KSeechan/Autonomous-Rover/Rover Pictures/1.jpg

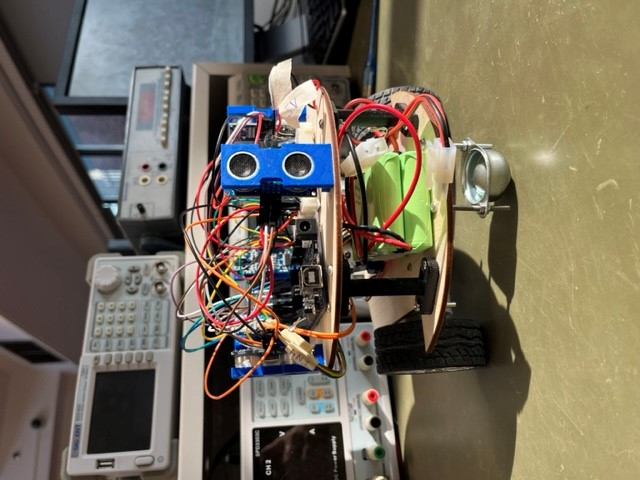
Rover Pictures/1.jpg
