KSeechan/Autonomous-Rover/Rover Pictures/8.jpg

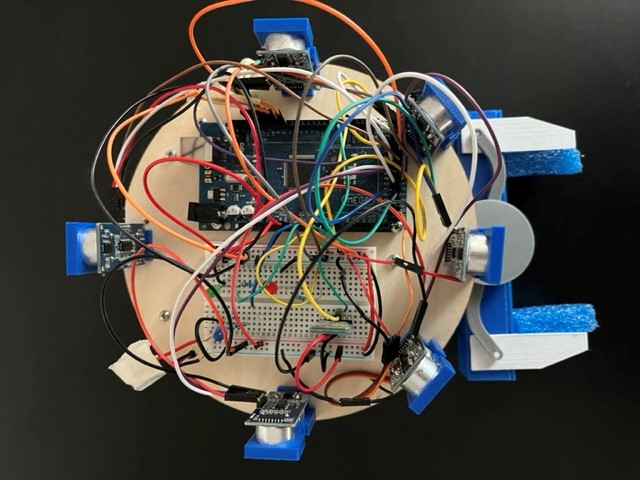
Rover Pictures/8.jpg
