KSeechan/Autonomous-Rover/README.md

# Autonomous-Rover
Arduino powered obstacle avoidance robot
