KSeechan/Autonomous-Rover/Rover Pictures/3.jpg

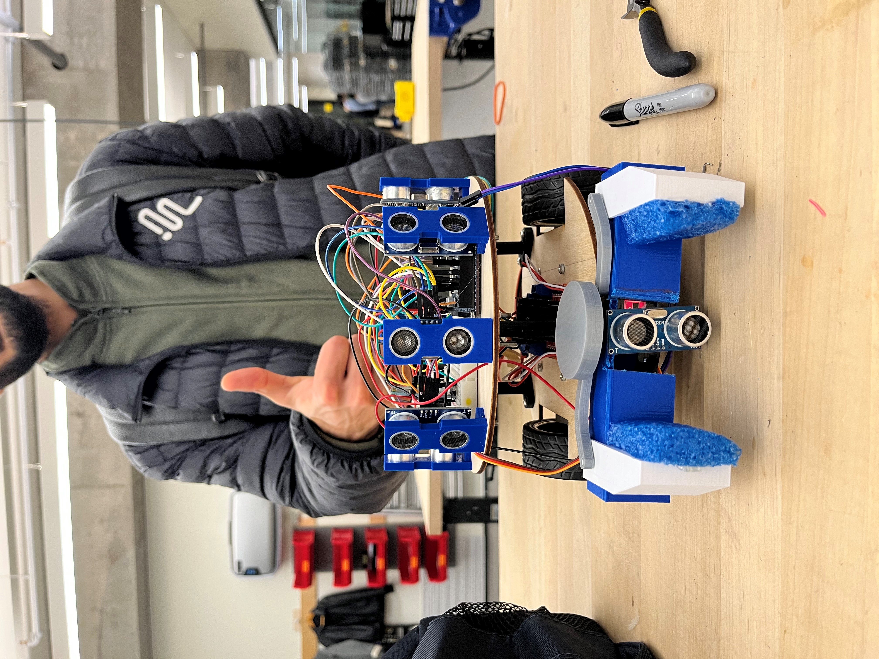
Rover Pictures/3.jpg
