KSeechan/Autonomous-Rover/Rover Pictures/5.jpg

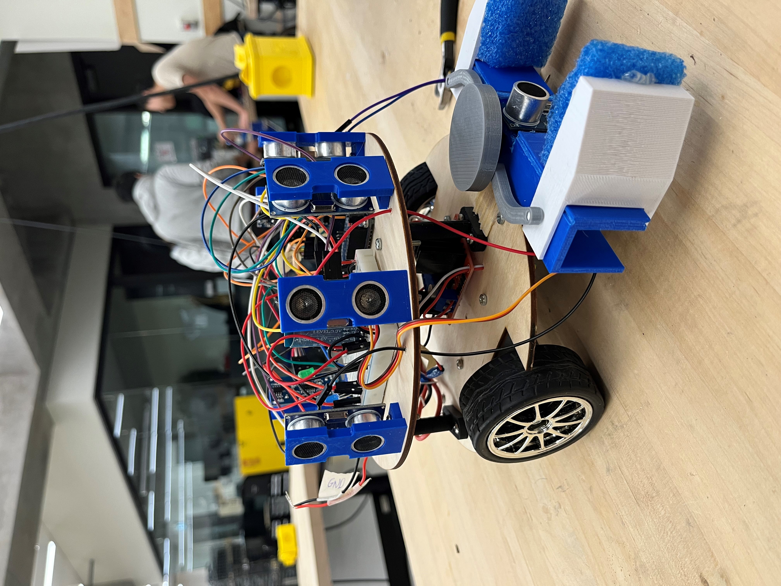
Rover Pictures/5.jpg
