KSeechan/Autonomous-Rover/Rover Pictures/6.jpg

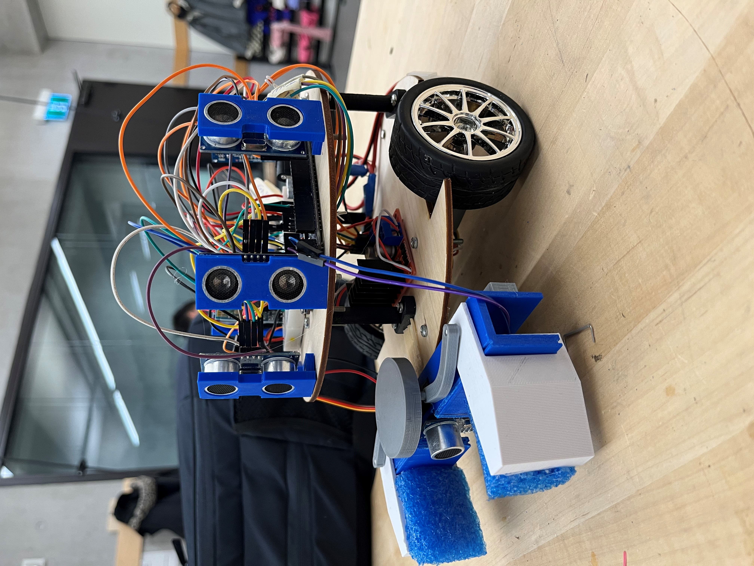
Rover Pictures/6.jpg
