KSeechan/Autonomous-Rover/Rover Pictures/7.jpg

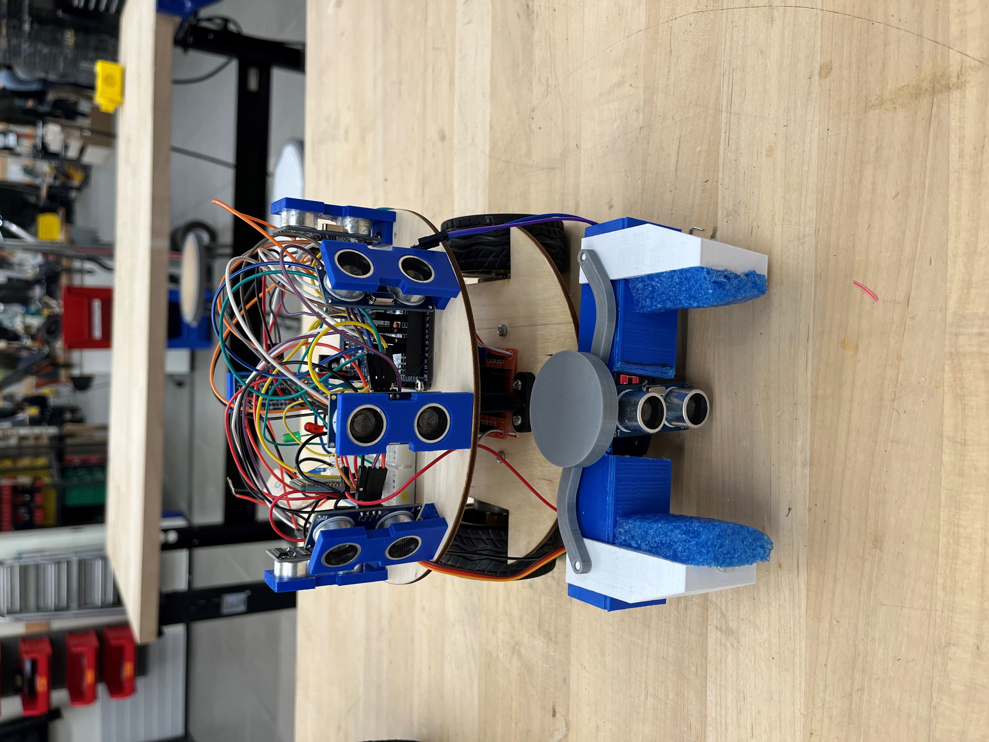
Rover Pictures/7.jpg
