KSeechan/Autonomous-Rover/Rover Pictures/9.jpg

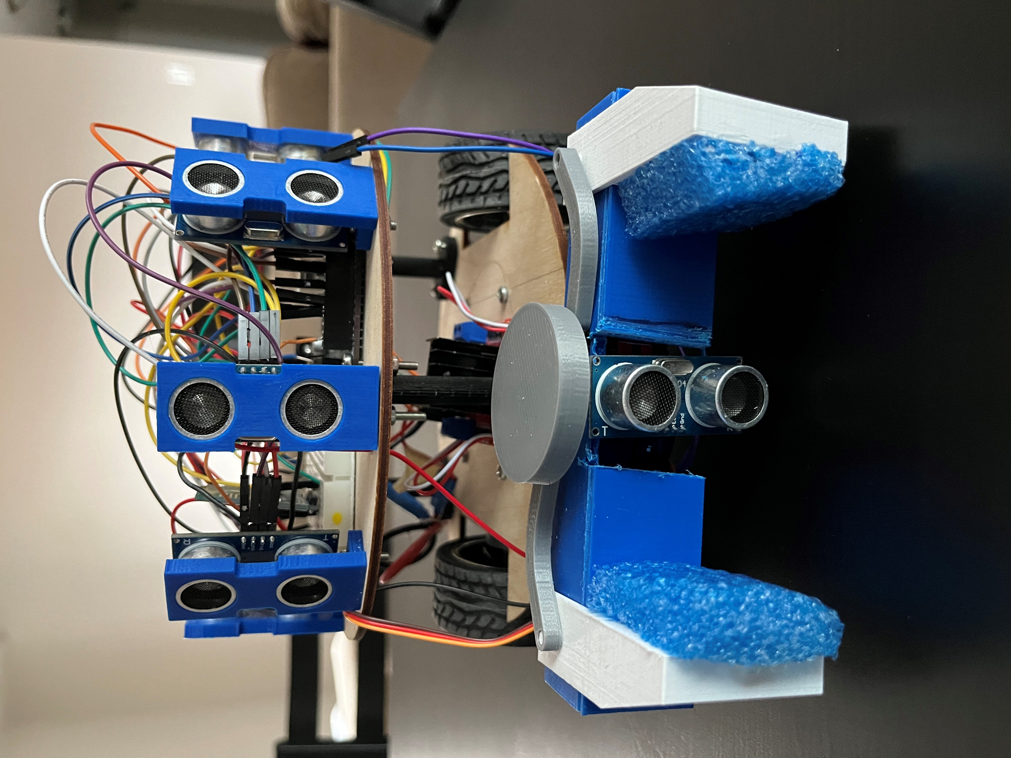
Rover Pictures/9.jpg
