KSeechan/Autonomous-Rover/Rover Pictures/4.jpg

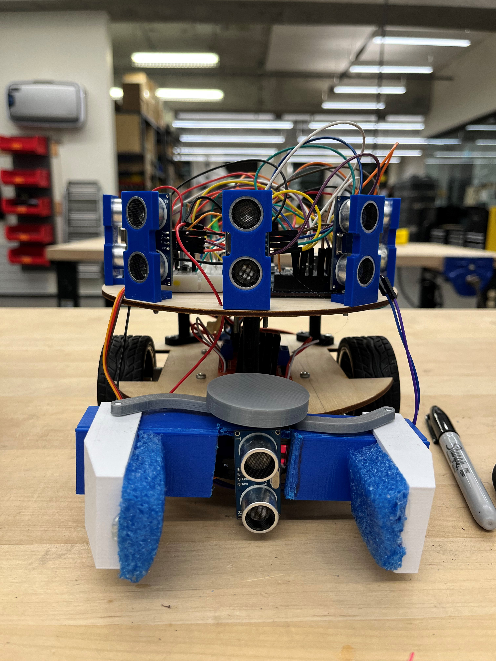
Rover Pictures/4.jpg
